Zhao511/WaterQualityMonitoring/web项目说明文档.md

# WaterQualityMonitor 智慧水质监测系统 - Web端说明文档
## 项目概述
本项目是一套基于Web的**智慧水质物联网监测系统**控制面板，搭配以STM32F103C8T6为核心的野外水质监测终端，实现河道、鱼塘、水库等水域水质参数**实时采集、远程监控、设备管理、异常告警**全流程可视化操作，支持点位身份配置、云端对接、阈值预警与设备状态管控，适配野外无人值守式水质常态化监测场景。

---
## 一、标签页结构
系统采用二级导航结构，左侧为一级导航栏，右侧内容区顶部为二级导航栏。
### 1.1 一级导航标签页
| 标签页名称 | 路由标识 | 说明 |
|---|---|---|
| **运营首页** | home | 系统主界面，展示水质传感器数据、设备状态与远程控制功能 |
| **更多信息** | set | 系统参数、平台连接、设备地址配置及版本管理 |

### 1.2 二级导航标签页
#### 运营首页 下包含：
| 标签页名称 | 路由标识 | 说明 |
|---|---|---|
| **主页** | home/main | 核心监控页面，展示全量水质数据、点位信息、设备控制面板与告警设置 |

#### 更多信息 下包含：
| 标签页名称 | 路由标识 | 说明 |
|---|---|---|
| **IDKey** | set/IDKEY | 配置华为云IoT平台连接参数，建立终端与云端数据通道 |
| **MAC设置** | set/MAC | 配置水质监测终端、RFID点位、GPS定位、LoRa通信模块地址 |
| **版本信息** | set/about | 查看系统版本、升级日志、APP下载及本地缓存清理 |

---
## 二、各标签页详细说明
### 2.1 主页（home/main）
**作用**：系统核心监控界面，实时展示水质参数、点位身份、定位信息、设备在线状态，提供阈值设置、模式切换、本地状态查看及告警控制功能。
#### 包含的控件：
| 序号 | 控件名称 | 控件类型 | 说明 |
|-----|---|---|---|
| 1 | **水温面板** | 仪表盘图表 | 显示实时水体温度，范围-20~100℃，附带设备在线/离线状态指示 |
| 2 | **pH值面板** | 仪表盘图表 | 显示水体pH数值，标准监测范围0~14，附带设备在线/离线状态指示 |
| 3 | **电导率(EC/TDS)面板** | 仪表盘图表 | 显示水体电导率/TDS数据，附带设备在线/离线状态指示 |
| 4 | **浊度面板** | 仪表盘图表 | 显示水体浊度数据，附带设备在线/离线状态指示 |
| 5 | **RFID点位标识面板** | 状态显示区 | 展示当前监测点位唯一RFID编号，用于点位溯源与分区管理 |
| 6 | **GPS定位面板** | 状态显示区 | 展示监测点位经纬度信息，支持空间定位与地图关联 |
| 7 | **设备状态指示灯面板** | 状态显示区 | 同步终端RGB三色LED状态，直观展示水质正常/异常/预警状态 |
| 8 | **水质综合告警面板** | 图片+按钮 | 显示告警状态，点击按钮可手动开启/关闭全域水质异常报警 |
| 9 | **水温阈值滑块** | 滑块控件 | 设置水温报警阈值，范围0~100℃ |
| 10 | **pH值阈值滑块** | 滑块控件 | 设置pH值上下限报警阈值，范围0~14 |
| 11 | **电导率阈值滑块** | 滑块控件 | 设置电导率/TDS报警阈值 |
| 12 | **浊度阈值滑块** | 滑块控件 | 设置浊度报警阈值 |
| 13 | **模式切换** | 单选按钮组 | 自动模式/手动模式切换 |

#### 功能说明：
- **自动模式**：当水温、pH、电导率、浊度任一参数超出预设阈值时，系统自动触发告警；参数恢复正常后告警自动关闭。
- **手动模式**：由管理人员手动开启、关闭水质告警提示。
- 所有终端采集数据、RFID编号、GPS定位信息通过数据服务实时推送，页面自动刷新更新。

### 2.2 IDKey（set/IDKEY）
**作用**：配置与**华为云IoT平台**对接的认证参数，建立前端页面、LoRa网关、水质终端与云端平台的数据传输链路。
#### 包含的控件：
| 序号 | 控件名称 | 控件类型 | 说明 |
|-----|---|---|---|
| 1 | **ID输入框** | 文本输入框 | 华为云IoT平台设备/账户ID |
| 2 | **KEY输入框** | 文本输入框 | 华为云IoT平台接入密钥 |
| 3 | **SERVER输入框** | 文本输入框 | 华为云IoT平台服务器地址 |
| 4 | **确认按钮** | 按钮 | 保存参数，连接/断开云端数据服务 |
| 5 | **扫描按钮** | 按钮 | 安卓端可用，扫描二维码自动填充ID/KEY/服务器地址 |
| 6 | **分享按钮** | 按钮 | 生成当前云平台配置二维码，供其他设备快速导入配置 |

### 2.3 MAC设置（set/MAC）
**作用**：配置各硬件模块通信地址，区分不同监测终端、传感器、RFID点位、LoRa网关设备，精准接收多点位水质数据。
#### 包含的控件：
| 序号 | 控件名称 | 控件类型 | 说明 |
|-----|---|---|---|
| 1 | **Sensor_A输入框** | 文本输入框 | 水质综合传感器MAC（水温、pH、电导率、浊度） |
| 2 | **Sensor_B输入框** | 文本输入框 | RFID点位识别模块MAC，用于点位身份校验与溯源 |
| 3 | **Sensor_C输入框** | 文本输入框 | GPS定位+LoRa通信模块MAC，负责定位与无线数据传输 |
| 4 | **确认按钮** | 按钮 | 保存MAC地址并查询各模块在线运行状态 |
| 5 | **扫描按钮** | 按钮 | 安卓端可用，扫描二维码自动批量填充MAC地址 |
| 6 | **分享按钮** | 按钮 | 生成当前MAC配置二维码，便于多设备统一配置 |

#### 传感器/模块分工：
| 设备模块 | 采集/实现功能 |
|---|---|
| Sensor_A | 水温、pH值、电导率(EC/TDS)、浊度四大水质参数采集 |
| Sensor_B | RFID电子标签识别，点位身份编码、巡检溯源、分区管理 |
| Sensor_C | GPS经纬度定位、LoRa低功耗无线数据收发传输 |

### 2.4 版本信息（set/about）
**作用**：查看系统版本、升级日志，提供移动端APP下载入口与浏览器本地缓存清理功能。
#### 包含的控件：
| 序号 | 控件名称 | 控件类型 | 说明 |
|-----|---|---|---|
| 1 | **查看下载二维码** | 链接/按钮 | 弹出模态框显示安卓APP下载二维码，移动端扫码即可安装 |
| 2 | **当前版本显示** | 文本显示 | 展示Web管理端当前软件版本号 |
| 3 | **版本升级按钮** | 按钮 | 在线检查并执行系统版本升级 |
| 4 | **查看升级日志按钮** | 按钮 | 展开/收起系统版本迭代、功能更新历史记录 |
| 5 | **清除localStorage按钮** | 按钮 | 清除浏览器本地缓存的云平台参数、MAC地址、阈值等配置数据 |

---
## 三、公共控件与模态框
### 3.1 二维码分享窗口（qrModal）
- 用于分享华为云IDKey、设备MAC等配置信息
- 生成JSON格式二维码，其他设备扫码可一键导入配置，快速部署

### 3.2 下载二维码窗口（downloadModal）
- 展示移动端管理APP下载二维码
- 手机扫码可直接下载安装安卓客户端，实现移动端远程监控

### 3.3 延时弹出提示框（toast）
- 页面右下角自动弹出操作反馈提示，超时自动消失
- 用于展示云端连接状态、配置保存结果、设备在线状态、告警触发等信息

---
## 四、配置文件说明
### config.js 核心配置项：
| 配置项 | 默认值 | 说明 |
|---|---|---|
| id | 1234567890 | 华为云IoT平台用户/设备ID |
| key | ABCDEFGHIJKLMNOPQRSTUVWXYZ | 华为云IoT平台接入密钥 |
| server | iot-cloud.huawei.com | 华为云IoT平台服务器地址 |
| Sensor_A | 00:00:00:00:00:00:00:00 | 水质综合传感器MAC地址 |
| Sensor_B | 00:00:00:00:00:00:00:00 | RFID点位模块MAC地址 |
| Sensor_C | 00:00:00:00:00:00:00:00 | GPS+LoRa通信模块MAC地址 |
| curMode | manual-mode | 系统默认运行模式：手动模式 |
| Tem_threshold | 50 | 水温默认报警阈值 |
| Ph_min | 6 | pH值下限报警阈值 |
| Ph_max | 9 | pH值上限报警阈值 |
| Ec_threshold | 1000 | 电导率默认报警阈值 |
| Turb_threshold | 500 | 浊度默认报警阈值 |

---
## 五、技术架构
| 技术/库 | 用途 |
|---|---|
| jQuery | 页面DOM操作、事件监听与数据交互 |
| Bootstrap | 搭建响应式前端UI界面，适配电脑、平板、手机 |
| FusionCharts | 水质参数仪表盘、数据图表可视化展示 |
| Director.js | 前端路由管理，实现多标签页切换 |
| nstSlider | 各类水质参数阈值调节滑块控件 |
| labelauty | 单选按钮美化，优化模式切换交互体验 |
| QRCode.js | 动态生成配置分享、APP下载二维码 |
| 云端数据服务 | 对接华为云IoT平台，接收STM32终端上传的水质、定位、RFID数据 |

*文档生成日期：2026-06-05*
