Zhao511/WaterQualityMonitoring/(list of files, drawings)

Other design files:
Untitled Sketch 2.fzz
