Zhao511/WaterQualityMonitoring/WaterQuality_Terminal/Core/Src/main.c

/**
 * ============================================================
 * 智慧水质监测系统 — FreeRTOS + 华为云 IoT 物模型
 * ============================================================
 * 架构: STM32F103 ←LoRa→ ESP32网关 ←MQTT→ 华为云IoT
 * MCU:  STM32F103C8T6  |  RTOS: FreeRTOS
 * SRAM: 20KB           |  Flash: 64KB
 * ============================================================
 * 任务架构 (6 个任务):
 *
 *   vWatchdogTask(Prio 4, Stack 128W) — IWDG 看门狗监控 + 心跳检查
 *   vSensorTask  (Prio 3, Stack 384W) — 传感器 5s 采集 + 告警判定
 *   vGPSTask     (Prio 2, Stack 256W) — GPS 1s 轮询 (按需开启) + NMEA→Decimal
 *   vIOTTask     (Prio 2, Stack 512W) — LoRa 收发 + 4 服务上报 + 命令处理
 *   vRFIDTask    (Prio 1, Stack 128W) — RFID 2s 扫描
 *   vLEDTask     (Prio 1, Stack 128W) — 水质 & 命令 LED 指示
 * ============================================================
 */

#include "stm32f10x.h"

/* FreeRTOS */
#include "FreeRTOS.h"
#include "task.h"
#include "queue.h"
#include "semphr.h"

/* 驱动层 */
#include "led_rgb.h"
#include "sensor_ph.h"
#include "sensor_turbidity.h"
#include "sensor_temp.h"
#include "sensor_tds.h"
#include "adc_common.h"
#include "lora.h"
#include "gps.h"
#include "rc522.h"
#include "usart_debug.h"
#include "watchdog.h"

/* IoT 物模型 */
#include "iot_model.h"
#include "iot_json.h"
#include "iot_service.h"

#include <stdio.h>
#include <string.h>

/* ================================================================
 * 编译期开关: 原始 ADC 诊断输出
 *   0 = 禁用 (生产模式, 节省栈空间)
 *   1 = 启用 (调试模式, 每 60 轮输出一次原始 ADC 值)
 * ================================================================ */
#define RAW_ADC_DEBUG_ENABLED  0

/* ================================================================
 * 全局物模型实例 (iot_service.h 中 extern 声明)
 * ================================================================ */
WaterStatus  g_water_status;
DeviceStatus g_device_status;
GPS          g_gps_data;
uint32_t     g_report_interval_sec = IOT_DEFAULT_REPORT_INTERVAL;
uint8_t      g_terminal_addr = 0;    /* 终端LoRa地址: 0=广播, 读到RFID后自动设为UID最后一字节 */
bool         g_gps_enabled  = false;  /* GPS按需开关: 上报窗口期/命令请求时开启 */
bool         g_pending_device_status_report = false;  /* A0/A1 触发延迟上报 */

/* ================================================================
 * 旧版数据结构 (保留用于队列兼容, 后续逐步迁移)
 * ================================================================ */
typedef struct {
    float ph;
    float turbidity;
    float temperature;
    float tds;
} SensorData;

typedef struct {
    uint8_t tag_id[5];
    uint8_t tag_valid;
} RFIDData;

/* ================================================================
 * FreeRTOS 队列 & 互斥量
 * ================================================================ */
static QueueHandle_t xSensorQueue  = NULL;
static QueueHandle_t xGPSQueue     = NULL;
static QueueHandle_t xRFIDQueue    = NULL;
static QueueHandle_t xLEDQueue     = NULL;
static QueueHandle_t xAlarmQueue   = NULL;   /* 告警事件队列 */
static SemaphoreHandle_t xDebugMutex = NULL;
static SemaphoreHandle_t xWaterMutex = NULL;  /* 保护 g_water_status 并发访问 */
static SemaphoreHandle_t xGPSMutex   = NULL;  /* 保护 g_gps_data 并发访问 */
SemaphoreHandle_t xADCMutex   = NULL;  /* 保护 ADC1 并发访问 (extern 给 adc_common.c) */
static TaskHandle_t xWatchdogTaskHandle = NULL;

/* 任务运行计数器 (周期性日志输出, 避免刷屏) */
static uint32_t g_sensor_cycle = 0;
static uint32_t g_gps_cycle    = 0;
static uint32_t g_iot_cycle    = 0;
static uint32_t g_rfid_cycle   = 0;
static uint32_t g_led_cycle    = 0;

/* 即时上报信号 */
static TaskHandle_t xSensorTaskHandle = NULL;
TaskHandle_t xIOTTaskHandle = NULL;
#define IOT_IMMEDIATE_REPORT_BIT   0x01

/* ================================================================
 * 函数声明
 * ================================================================ */
static uint8_t  ReadRFIDTag(uint8_t *tag_id, uint8_t *out_status);

/* 任务函数 */
static void vSensorTask(void *pvParameters);
static void vGPSTask(void *pvParameters);
static void vRFIDTask(void *pvParameters);
static void vIOTTask(void *pvParameters);
static void vLEDTask(void *pvParameters);
static void vWatchdogTask(void *pvParameters);

/* 传输层外部函数 (iot_transport.c) */
extern void IOT_Report_DeviceStatus(const DeviceStatus *s);
extern void IOT_Report_WaterStatus(const WaterStatus *s);
extern void IOT_Report_Alarm(const Alarm *a);
extern void IOT_Report_GPS(const GPS *g);
extern void IOT_Process_Incoming(void);
extern void IOT_Collect_All_Sensors(WaterStatus *ws);

/* ================================================================
 * RFID 读卡辅助
 * ================================================================ */
static uint8_t ReadRFIDTag(uint8_t *tag_id, uint8_t *out_status)
{
    uint8_t status;
    uint8_t tag_type[2];

    status = RC522_Request(PICC_REQA, tag_type);
    if (out_status) *out_status = status;
    if (status != MI_OK) return 0;

    status = RC522_SelectTag(tag_id);
    return (status == MI_OK) ? 1 : 0;
}

/* ================================================================
 * 任务 1 — 传感器采集 (Prio 3, 5s 周期, 常态 RX 不频繁切换)
 * ================================================================ */
static void vSensorTask(void *pvParameters)
{
    TickType_t xLastWakeTime = xTaskGetTickCount();
    const TickType_t xPeriod = pdMS_TO_TICKS(5000);  /* 5s 采集, 常态 RX */

    SensorData sensor_data;

    for (;;)
    {
        /* 首次启动延时: 确保 ADC、传感器供电和外部电路完全稳定 */
        if (g_sensor_cycle == 0) {
            vTaskDelay(pdMS_TO_TICKS(500));
        }

        /* 读取所有传感器 + 校准 + 物理范围验证 */
        float raw_ph, raw_temp, raw_tds;

        raw_ph = IOT_Apply_Calibration("ph", PH_Sensor_Read());
        IOT_Validate_SensorData("ph", raw_ph, &sensor_data.ph);

#if TURBIDITY_SENSOR_ENABLED
        {
            float raw_turb = IOT_Apply_Calibration("turbidity", Turbidity_Sensor_Read());
            IOT_Validate_SensorData("turbidity", raw_turb, &sensor_data.turbidity);
        }
#else
        sensor_data.turbidity   = 0;  /* 无浊度传感器, 固定为 0 */
#endif

        raw_temp = IOT_Apply_Calibration("temp", Temp_Sensor_Read());
        IOT_Validate_SensorData("temp", raw_temp, &sensor_data.temperature);

        /* 温度合理性检查 → TDS 补偿用 (使用物理范围常量) */
        float temp = sensor_data.temperature;
        if (temp < IOT_TEMP_VALID_MIN || temp > IOT_TEMP_VALID_MAX)
            temp = IOT_TEMP_DEFAULT;

        raw_tds = IOT_Apply_Calibration("tds", TDS_Sensor_Read(temp));
        IOT_Validate_SensorData("tds", raw_tds, &sensor_data.tds);

        /* 更新全局物模型 WaterStatus (加锁保护) */
        if (xSemaphoreTake(xWaterMutex, pdMS_TO_TICKS(50)) == pdPASS)
        {
            g_water_status.ph        = sensor_data.ph;
            g_water_status.tds       = sensor_data.tds;
            g_water_status.temp      = sensor_data.temperature;
            g_water_status.turbidity = sensor_data.turbidity;
            xSemaphoreGive(xWaterMutex);
        }

        /* 写入传感器队列 (供 IOT 任务消费) */
        xQueueOverwrite(xSensorQueue, &sensor_data);

        /* 水质评估 → LED (已移除: LED 由平台 A0/A1 告警命令控制) */

        /* 告警检测已移至 Web/App 端 — 终端不再做阈值判断
         * Alarm alarm;
         * if (IOT_Alarm_Check(&g_water_status, g_water_status.rfid, &alarm) != 0) {
         *     xQueueSend(xAlarmQueue, &alarm, 0);
         * } */

        /* 调试输出 (含阈值, 便于判断 LED 颜色原因) */
        if (xSemaphoreTake(xDebugMutex, pdMS_TO_TICKS(100)) == pdPASS)
        {
            Debug_Printf("PH:%.2f[%.1f-%.1f] TDS:%.1f[<%.0f] Temp:%.1f[%.0f-%.0f] Turb:%.1f\r\n",
                         sensor_data.ph, g_water_status.ph_min, g_water_status.ph_max,
                         sensor_data.tds, g_water_status.tds_max,
                         sensor_data.temperature, g_water_status.temp_min, g_water_status.temp_max,
                         sensor_data.turbidity);
            /* LED 判定细节 */
            uint8_t fc = 0;
            if (sensor_data.ph < g_water_status.ph_min || sensor_data.ph > g_water_status.ph_max) fc++;
            if (sensor_data.tds > g_water_status.tds_max) fc++;
            if (sensor_data.temperature < g_water_status.temp_min || sensor_data.temperature > g_water_status.temp_max) fc++;
            Debug_Printf("[Sensor] fail_count=%u -> LED=%s | cycle=%lu\r\n",
                         fc,
                         fc == 0 ? "GREEN" : (fc == 1 ? "YELLOW" : "RED"),
                         (unsigned long)g_sensor_cycle);
            xSemaphoreGive(xDebugMutex);
        }

        /* 心跳 + 周期日志 (每 10 轮 ≈ 10s 输出摘要) */
        g_sensor_cycle++;
        WDG_Heartbeat(HEARTBEAT_SENSOR);

        if ((g_sensor_cycle % 10) == 0) {
            if (xSemaphoreTake(xDebugMutex, pdMS_TO_TICKS(100)) == pdPASS) {
                Debug_Printf("[Sensor] cycle=%lu | PH=%.2f TDS=%.1f Temp=%.1f Turb=%.1f\r\n",
                             g_sensor_cycle, sensor_data.ph, sensor_data.tds,
                             sensor_data.temperature, sensor_data.turbidity);
                xSemaphoreGive(xDebugMutex);
            }
        }

#if RAW_ADC_DEBUG_ENABLED
        /* 诊断: 每 10 轮 (~10s) 输出原始 ADC 采样值
         *   - 放在 WDG_Heartbeat 之后: 故障前心跳已上报
         *   - 使用 xDebugMutex 保护 Debug_Printf */
        if ((g_sensor_cycle % 10) == 0) {
            uint16_t r_ph, r_tds, r_turb, r_temp;
            uint8_t  ok_ph, ok_tds, ok_turb, ok_temp;
            ok_ph   = ADC_ReadChannel(ADC_CH_PH,        &r_ph);
            ok_tds  = ADC_ReadChannel(ADC_CH_TDS,       &r_tds);
            ok_turb = ADC_ReadChannel(ADC_CH_TURBIDITY, &r_turb);
            ok_temp = ADC_ReadChannel(ADC_CH_TEMP,      &r_temp);
            if (xSemaphoreTake(xDebugMutex, pdMS_TO_TICKS(100)) == pdPASS) {
                Debug_Printf("[RAW ADC] cycle=%lu | pH=%s%u TDS=%s%u Turb=%s%u Temp=%s%u\r\n",
                             g_sensor_cycle,
                             (ok_ph   == ADC_READ_OK) ? "" : "TMO:", r_ph,
                             (ok_tds  == ADC_READ_OK) ? "" : "TMO:", r_tds,
                             (ok_turb == ADC_READ_OK) ? "" : "TMO:", r_turb,
                             (ok_temp == ADC_READ_OK) ? "" : "TMO:", r_temp);
                xSemaphoreGive(xDebugMutex);
            }
        }
#endif

        vTaskDelayUntil(&xLastWakeTime, xPeriod);
    }
}

/* ================================================================
 * 任务 2 — GPS 解析 (Prio 2, 1s 周期)
 * ================================================================ */
static void vGPSTask(void *pvParameters)
{
    GPS_Data raw_gps;

    for (;;)
    {
        if (g_gps_enabled) {
            GPS_ProcessData();
            GPS_GetData(&raw_gps);

            if (raw_gps.fix > 0)
            {
                xQueueOverwrite(xGPSQueue, &raw_gps);

                /* 转换为物模型 GPS (decimal degrees), 加锁保护 */
                if (xSemaphoreTake(xGPSMutex, pdMS_TO_TICKS(50)) == pdPASS)
                {
                    IOT_GPS_GetDecimal(&g_gps_data);
                    xSemaphoreGive(xGPSMutex);
                }

                if (xSemaphoreTake(xDebugMutex, pdMS_TO_TICKS(100)) == pdPASS)
                {
                    Debug_Printf("GPS: %.6f,%.6f Fix=%d Sat=%d\r\n",
                                 g_gps_data.latitude, g_gps_data.longitude,
                                 raw_gps.fix, raw_gps.satellites);
                    xSemaphoreGive(xDebugMutex);
                }

                /* 电子围栏检查已移至 Web/App 端 — 终端不再做告警判定
                 * if ((g_gps_cycle % 10) == 0) {
                 *     if (IOT_GeoFence_Check(...) != 0) { ... }
                 * } */
            }

            g_gps_cycle++;

            if ((g_gps_cycle % 10) == 0) {
                if (xSemaphoreTake(xDebugMutex, pdMS_TO_TICKS(100)) == pdPASS) {
                    Debug_Printf("[GPS] cycle=%lu | Fix=%d Sat=%d\r\n",
                                 g_gps_cycle, raw_gps.fix, raw_gps.satellites);
                    xSemaphoreGive(xDebugMutex);
                }
            }
        }

        WDG_Heartbeat(HEARTBEAT_GPS);
        vTaskDelay(pdMS_TO_TICKS(1000));  /* 1s 周期, GPS使能时读数, 禁用时空转 */
    }
}

/* ================================================================
 * 任务 3 — RFID 扫描 (Prio 1, 2s 周期)
 * ================================================================ */
static void vRFIDTask(void *pvParameters)
{
    TickType_t xLastWakeTime = xTaskGetTickCount();
    const TickType_t xPeriod = pdMS_TO_TICKS(2000);  /* 2s RFID, 降低总线占用 */

    RFIDData rfid = {0};
    uint8_t  last_status = 0xFF;  /* 最近一次 RC522_Request 状态 */

    for (;;)
    {
        rfid.tag_valid = ReadRFIDTag(rfid.tag_id, &last_status);

        if (rfid.tag_valid)
        {
            xQueueOverwrite(xRFIDQueue, &rfid);

            /* 更新物模型 RFID */
            snprintf(g_water_status.rfid, IOT_RFID_LEN,
                     "%02X%02X%02X%02X%02X",
                     rfid.tag_id[0], rfid.tag_id[1],
                     rfid.tag_id[2], rfid.tag_id[3],
                     rfid.tag_id[4]);

            /* 从 RFID UID 最后一字节自动派生终端 LoRa 地址
             * 避开 0x00(广播) 和 0xFF(保留), 确保每个终端有唯一地址 */
            g_terminal_addr = rfid.tag_id[4];
            if (g_terminal_addr == 0 || g_terminal_addr == 0xFF) {
                g_terminal_addr = 1;
            }

            if (xSemaphoreTake(xDebugMutex, pdMS_TO_TICKS(100)) == pdPASS)
            {
                Debug_Printf("RFID: %s\r\n", g_water_status.rfid);
                xSemaphoreGive(xDebugMutex);
            }
        }

        /* 心跳 + 周期日志 (每 10 轮 ≈ 5s 输出摘要) */
        g_rfid_cycle++;
        WDG_Heartbeat(HEARTBEAT_RFID);

        if ((g_rfid_cycle % 10) == 0) {
            if (xSemaphoreTake(xDebugMutex, pdMS_TO_TICKS(100)) == pdPASS) {
                Debug_Printf("[RFID] cycle=%lu | stat=%d (0=OK 1=NOTAG 2=ERR)\r\n",
                             g_rfid_cycle, last_status);
                xSemaphoreGive(xDebugMutex);
            }
        }

        vTaskDelayUntil(&xLastWakeTime, xPeriod);
    }
}

/* ================================================================
 * 任务 4 — IoT 通信 (Prio 2, 可调上报周期)
 *   - 消费 LoRa RX → 命令解析分发
 *   - 定时上报 4 服务属性 (WaterStatus/DeviceStatus/GPS/Alarm)
 * ================================================================ */
static void vIOTTask(void *pvParameters)
{
    TickType_t xLastWakeTime = xTaskGetTickCount();
    uint32_t   tick_count    = 0;
    uint32_t   last_device_status = 0;
    uint32_t   last_gps_report    = 0;

    SensorData sensor_data;
    RFIDData   rfid_data;
    GPS_Data   raw_gps;
    Alarm      alarm;

    /* tick_count 为秒计数器, 直接与秒值比较 */
    tick_count = 1;  /* 从 1 开始, 避免首发空数据 */

    /* 启动延迟: 等 ESP32 完成 WiFi+NTP+MQTT 初始化 (~15s)
     * 分段 delay + 喂狗, 避免触发 WDG 复位 */
    Debug_Printf("[IoT] Waiting 15s for ESP32 gateway init...\r\n");
    for (int i = 0; i < 15; i++) {
        vTaskDelay(pdMS_TO_TICKS(1000));
        WDG_Heartbeat(HEARTBEAT_IOT);
    }
    Debug_Printf("[IoT] Start reporting\r\n");

    for (;;)
    {
        /* 诊断: 每 60 次循环 (~60s) 输出存活日志, 生产环境避免每秒打印
         * 注释: 将 % 60 改为 % 1 可恢复每秒打印 (调试用) */
        if ((tick_count % 60) == 0) {
            static uint32_t last_tick_time = 0;
            uint32_t now_tick = xTaskGetTickCount();
            uint32_t elapsed = (last_tick_time > 0) ? (now_tick - last_tick_time) : 0;
            Debug_Printf("[IoT] alive tick=%lu (elapsed=%lums)\r\n",
                         tick_count, (unsigned long)(elapsed * portTICK_PERIOD_MS));
            last_tick_time = now_tick;
        }

        /* --- LoRa 下行命令处理 (每次循环都检查) --- */
        IOT_Process_Incoming();

        /* --- 检查即时上报信号 --- */
        uint32_t notify;
        if (xTaskNotifyWait(0, 0, &notify, 0) == pdTRUE)
        {
            if (notify & IOT_IMMEDIATE_REPORT_BIT)
            {
                /* request_immediate_report: 全量采集 + 立即上报所有服务
                 * 加锁保护: 防止 vSensorTask(Prio3) 抢占造成数据撕裂 */
                if (xSemaphoreTake(xWaterMutex, pdMS_TO_TICKS(100)) == pdPASS)
                {
                    IOT_Collect_All_Sensors(&g_water_status);
                    IOT_Report_WaterStatus(&g_water_status);
                    IOT_DeviceStatus_Update(&g_device_status);
                    IOT_Report_DeviceStatus(&g_device_status);
                    if (xSemaphoreTake(xGPSMutex, pdMS_TO_TICKS(50)) == pdPASS)
                    {
                        IOT_Report_GPS(&g_gps_data);
                        xSemaphoreGive(xGPSMutex);
                    }
                    xSemaphoreGive(xWaterMutex);
                }
            }
        }

        /* --- 非阻塞消费各数据队列 (更新物模型) --- */
        xQueueReceive(xSensorQueue, &sensor_data, 0);
        xQueueReceive(xGPSQueue,    &raw_gps,     0);
        xQueueReceive(xRFIDQueue,   &rfid_data,   0);

        /* --- 定时: Water_status 上报 (可调间隔, 默认 5s) --- */
        if ((tick_count % g_report_interval_sec) == 0)
        {
            /* 更新 GPS 文本 (点位地理位置), 加锁保护
             * 仅在有 GPS Fix 时更新坐标; 无定位时设为空字符串 */
            if (xSemaphoreTake(xWaterMutex, pdMS_TO_TICKS(50)) == pdPASS)
            {
                if (xSemaphoreTake(xGPSMutex, pdMS_TO_TICKS(50)) == pdPASS)
                {
                    if (g_gps_data.gps_status != GPS_NO_FIX)
                    {
                        snprintf(g_water_status.gps, IOT_GPS_STR_LEN,
                                 "%.6f,%.6f", g_gps_data.longitude, g_gps_data.latitude);
                    }
                    else
                    {
                        g_water_status.gps[0] = '\0';  /* 未定位: 空字符串 */
                    }
                    xSemaphoreGive(xGPSMutex);
                }
                IOT_Report_WaterStatus(&g_water_status);
                xSemaphoreGive(xWaterMutex);
            }
        }

        /* --- 定时: DeviceStatus 上报 (60s) --- */
        if (tick_count - last_device_status >= IOT_DEVICE_STATUS_INTERVAL)
        {
            IOT_DeviceStatus_Update(&g_device_status);
            IOT_Report_DeviceStatus(&g_device_status);
            last_device_status = tick_count;
        }

        /* --- 定时: GPS 上报 (60s, 按需开启) ---
         * 上报前 15s 开启 GPS 预热, 上报后关闭以省电 */
        #define GPS_WARMUP_SEC  15
        if (tick_count - last_gps_report >= (IOT_GPS_REPORT_INTERVAL - GPS_WARMUP_SEC))
        {
            g_gps_enabled = true;  /* 提前开启预热 */
        }
        if (tick_count - last_gps_report >= IOT_GPS_REPORT_INTERVAL)
        {
            if (xSemaphoreTake(xGPSMutex, pdMS_TO_TICKS(50)) == pdPASS)
            {
                IOT_Report_GPS(&g_gps_data);
                xSemaphoreGive(xGPSMutex);
            }
            last_gps_report = tick_count;
            g_gps_enabled = false;  /* 上报完成, 关闭 GPS */
        }

        /* --- Alarm 上报 (限流: 最短间隔内同类型+相近值只发一次) --- */
        {
            static Alarm     last_sent;
            static uint32_t  last_sent_tick = 0;
            static bool      has_last = false;
            #define ALARM_MIN_INTERVAL_SEC  10    /* 同类告警最小间隔 */

            /* 只取队列最新一条, 中间积压的丢弃 */
            Alarm latest;
            bool  has_alarm = false;
            while (xQueueReceive(xAlarmQueue, &alarm, 0) == pdPASS)
            {
                latest = alarm;
                has_alarm = true;
            }

            if (has_alarm)
            {
                /* 去重: 同类型 + 值变化<0.5 且间隔<10s → 跳过 */
                bool same_type = has_last &&
                    (latest.alarm_type == last_sent.alarm_type);
                float val_diff = (latest.current_value > last_sent.current_value)
                    ? (latest.current_value - last_sent.current_value)
                    : (last_sent.current_value - latest.current_value);
                uint32_t elapsed = tick_count - last_sent_tick;

                if (!has_last ||
                    !same_type ||
                    val_diff >= 0.5f ||
                    elapsed >= ALARM_MIN_INTERVAL_SEC)
                {
                    IOT_Report_Alarm(&latest);
                    last_sent      = latest;
                    last_sent_tick = tick_count;
                    has_last       = true;
                }
                /* 调试: 去重跳过时打印原因 */
                else if (xSemaphoreTake(xDebugMutex, pdMS_TO_TICKS(50)) == pdPASS)
                {
                    Debug_Printf("[IoT] Alarm %s suppressed (same type, diff=%.2f, %lus ago)\r\n",
                                 latest.alarm_id, val_diff, elapsed);
                    xSemaphoreGive(xDebugMutex);
                }
            }
        }

        /* ---- 上报后立即检查 RX (防止 TX 期间到达的数据积压) ---- */
        IOT_Process_Incoming();

        /* A0/A1 触发的延迟 DeviceStatus 上报 (避免在 IOT_Process_Incoming 内同步阻塞) */
        if (g_pending_device_status_report) {
            g_pending_device_status_report = false;
            IOT_DeviceStatus_Update(&g_device_status);
            IOT_Report_DeviceStatus(&g_device_status);
        }

        /* 心跳 + 周期日志 (每 5 轮 ≈ 5s 输出摘要) */
        g_iot_cycle++;
        WDG_Heartbeat(HEARTBEAT_IOT);

        if ((g_iot_cycle % 30) == 0) {
            if (xSemaphoreTake(xDebugMutex, pdMS_TO_TICKS(100)) == pdPASS) {
                Debug_Printf("[IoT] cycle=%lu | interval=%lus\r\n",
                             g_iot_cycle, g_report_interval_sec);
                xSemaphoreGive(xDebugMutex);
            }
        }

        tick_count++;
        vTaskDelay(pdMS_TO_TICKS(1000));  /* 1s 主循环 */
    }
}

/* ================================================================
 * 任务 5 — LED 状态指示 (Prio 1, 阻塞等待)
 * ================================================================ */
static void vLEDTask(void *pvParameters)
{
    LED_Color last_color = LED_COLOR_GREEN;  /* 初始为绿灯 */

    /* 确保初始 LED 状态正确 */
    LED_RGB_SetColor(LED_COLOR_GREEN);

    for (;;)
    {
        /* LED 由平台告警命令 (A0/A1) 控制, 此处周期同步确保一致性 */
        LED_Color color = g_device_status.alarm_active ? LED_COLOR_RED : LED_COLOR_GREEN;

        if (color != last_color) {
            LED_RGB_SetColor(color);
            if (xSemaphoreTake(xDebugMutex, pdMS_TO_TICKS(100)) == pdPASS) {
                Debug_Printf("[LED] -> %s (alarm_active=%s)\r\n",
                             g_device_status.alarm_active ? "RED" : "GREEN",
                             g_device_status.alarm_active ? "true" : "false");
                xSemaphoreGive(xDebugMutex);
            }
            last_color = color;
        }

        g_led_cycle++;
        WDG_Heartbeat(HEARTBEAT_LED);

        vTaskDelay(pdMS_TO_TICKS(2000));  /* 2s 周期同步 */
    }
}

/* ================================================================
 * 任务 6 — 看门狗监控 (Prio 4, 1s 周期)
 *   - 检查全部应用任务心跳 → 正常则喂狗, 异常则停止喂狗
 *   - 每 10s 输出心跳状态摘要
 * ================================================================ */
static void vWatchdogTask(void *pvParameters)
{
    TickType_t xLastWakeTime = xTaskGetTickCount();
    const TickType_t xPeriod = pdMS_TO_TICKS(1000);
    uint32_t cycle = 0;

    for (;;)
    {
        WDG_CheckAll();   /* 检查心跳 → 正常则喂狗, 异常则等待 IWDG 复位 */
        cycle++;

        /* 每 10 轮 (~10s) 输出看门狗状态摘要 */
        if ((cycle % 10) == 0) {
            if (xSemaphoreTake(xDebugMutex, pdMS_TO_TICKS(100)) == pdPASS) {
                WDG_PrintStatus();
                xSemaphoreGive(xDebugMutex);
            }
        }

        vTaskDelayUntil(&xLastWakeTime, xPeriod);
    }
}

/* ================================================================
 * main() — 系统初始化 & 调度器启动
 * ================================================================ */

/* FreeRTOS 栈溢出钩子 (configCHECK_FOR_STACK_OVERFLOW=1 时必须实现) */
void vApplicationStackOverflowHook(TaskHandle_t xTask, char *pcTaskName)
{
    (void)xTask;
    Debug_Printf("\r\n[FATAL] Stack overflow in task: %s\r\n", pcTaskName);
    /* 死循环 — 看门狗将在 ~4s 后复位系统 */
    taskDISABLE_INTERRUPTS();
    for (;;) { __NOP(); }
}

int main(void)
{
    /* ==============================================================
     * 最简 LED 闪烁 — 不依赖任何外设，仅验证程序到达 main()
     * 红灯 PB6 (共阳极: 低电平亮)
     * 闪烁 3 次 = main() 被成功调用
     * ============================================================== */
    {
        volatile uint32_t delay;
        RCC->APB2ENR |= RCC_APB2Periph_GPIOB;
        GPIOB->CRL &= ~((uint32_t)0x0F << 24);
        GPIOB->CRL |=  (uint32_t)0x03 << 24;
        GPIOB->BSRR = 0x0040;

        for (int n = 0; n < 3; n++)
        {
            GPIOB->BRR  = 0x0040;
            for (delay = 0; delay < 2400000; delay++) { __NOP(); }
            GPIOB->BSRR = 0x0040;
            for (delay = 0; delay < 2400000; delay++) { __NOP(); }
        }
    }

    /* ---- 硬件初始化 ---- */
    /* 调试串口必须最先初始化, 否则 LoRa/GPS 阻塞时无任何输出 */
    Debug_USART_Init();

    /* LED 闪 1 次: Debug_USART_Init 完成 */
    {
        volatile uint32_t d;
        GPIOB->BRR = 0x0040; for (d=0; d<800000; d++) __NOP();
        GPIOB->BSRR = 0x0040; for (d=0; d<800000; d++) __NOP();
    }

    SCB->SHCSR |= (1UL << 16)   /* MEMFAULTENA */
               | (1UL << 17)   /* BUSFAULTENA  */
               | (1UL << 18);  /* USGFAULTENA  */

    /* LED 闪 2 次: SHCSR 配置完成 */
    {
        volatile uint32_t d;
        for (int i=0; i<2; i++) {
            GPIOB->BRR = 0x0040; for (d=0; d<800000; d++) __NOP();
            GPIOB->BSRR = 0x0040; for (d=0; d<800000; d++) __NOP();
        }
    }

    Debug_Printf("\r\n");
    Debug_Printf("========================================\r\n");
    Debug_Printf("[BOOT] System starting... SYSCLK=%lu Hz\r\n", SystemCoreClock);
    {
        /* 复位检测: 打印 RCC 复位标志, 定位是上电复位还是看门狗复位 */
        uint32_t csr = RCC->CSR;
        Debug_Printf("[BOOT] RCC_CSR=0x%08lX", (unsigned long)csr);
        if (csr & 0x01000000) Debug_Printf(" LPWR");    /* 低功耗复位 */
        if (csr & 0x04000000) Debug_Printf(" WDG");      /* 窗口/独立看门狗复位 */
        if (csr & 0x08000000) Debug_Printf(" SW");       /* 软件复位 */
        if (csr & 0x10000000) Debug_Printf(" POR");      /* 上电复位 */
        if (csr & 0x20000000) Debug_Printf(" PIN");      /* 引脚复位 */
        Debug_Printf("\r\n");
        RCC->CSR |= 0x01000000;  /* 清除所有复位标志 */
    }
    Debug_Printf("========================================\r\n\r\n");

    /* LED 闪 3 次: 第一条 Debug_Printf 完成 */
    {
        volatile uint32_t d;
        for (int i=0; i<3; i++) {
            GPIOB->BRR = 0x0040; for (d=0; d<800000; d++) __NOP();
            GPIOB->BSRR = 0x0040; for (d=0; d<800000; d++) __NOP();
        }
    }

    /* ---- 逐项硬件初始化 (带进度日志, 便于定位崩溃点) ---- */
    Debug_Printf("[INIT] LED_RGB...\r\n");
    LED_RGB_Init();
    Debug_Printf("[INIT] LED_RGB OK\r\n");

    Debug_Printf("[INIT] ADC_Common...\r\n");
    ADC_Common_Init();
    Debug_Printf("[INIT] ADC_Common OK\r\n");

    Debug_Printf("[INIT] PH_Sensor...\r\n");
    PH_Sensor_Init();
    Debug_Printf("[INIT] PH_Sensor OK\r\n");

    Debug_Printf("[INIT] Turbidity_Sensor...\r\n");
    Turbidity_Sensor_Init();
    Debug_Printf("[INIT] Turbidity_Sensor OK\r\n");

    Debug_Printf("[INIT] Temp_Sensor...\r\n");
    Temp_Sensor_Init();
    Debug_Printf("[INIT] Temp_Sensor OK\r\n");

    Debug_Printf("[INIT] TDS_Sensor...\r\n");
    TDS_Sensor_Init();
    Debug_Printf("[INIT] TDS_Sensor OK\r\n");

    Debug_Printf("[INIT] GPS...\r\n");
    GPS_Init();
    Debug_Printf("[INIT] GPS OK\r\n");

    Debug_Printf("[INIT] LoRa... (AT scan, may take seconds)\r\n");
    LoRa_Init();
    Debug_Printf("[INIT] LoRa OK | AUX=%s (LOW=ready, HIGH=busy)\r\n", 
                LoRa_AuxReady() ? "LOW(ready)" : "HIGH(busy)");

    Debug_Printf("[INIT] RC522...\r\n");
    RC522_Init();
    Debug_Printf("[INIT] RC522 OK\r\n");

    /* 启动指示：绿灯 (alarm_active=false) — LED 由平台告警命令控制 */
    LED_RGB_SetColor(LED_COLOR_GREEN);
    Debug_Printf("\r\n========================================\r\n");
    Debug_Printf(" Water Quality Monitor - FreeRTOS v2.0\r\n");
    Debug_Printf(" STM32F103C8T6 | 72MHz | IoT 4-Service\r\n");
    Debug_Printf("========================================\r\n");

    for (volatile uint32_t i = 0; i < 2000000; i++) { __NOP(); }

    /* ---- IoT 物模型初始化 ---- */
    IOT_DeviceStatus_Init(&g_device_status);
    IOT_Threshold_Init(&g_water_status);
    IOT_Alarm_Init();
    IOT_Calibration_Init();
    memset(&g_gps_data, 0, sizeof(g_gps_data));

    Debug_Printf("IoT Model: 4 services initialized\r\n");

    /* ---- 打印任务配置表 ---- */
    WDG_PrintTaskTable();

    /* ---- 创建 FreeRTOS 队列 ---- */
    xSensorQueue = xQueueCreate(1, sizeof(SensorData));
    xGPSQueue    = xQueueCreate(1, sizeof(GPS_Data));
    xRFIDQueue   = xQueueCreate(1, sizeof(RFIDData));
    xLEDQueue    = xQueueCreate(1, sizeof(LED_Color));
    xAlarmQueue  = xQueueCreate(4, sizeof(Alarm));     /* 告警缓冲 */
    xDebugMutex  = xSemaphoreCreateMutex();
    xWaterMutex  = xSemaphoreCreateMutex();            /* 保护 g_water_status */
    xGPSMutex    = xSemaphoreCreateMutex();            /* 保护 g_gps_data      */
    xADCMutex    = xSemaphoreCreateMutex();            /* 保护 ADC1 并发访问   */

    /* 验证内核对象 */
    if (xSensorQueue == NULL || xGPSQueue    == NULL ||
        xRFIDQueue   == NULL || xLEDQueue    == NULL ||
        xAlarmQueue  == NULL || xDebugMutex  == NULL || xWaterMutex == NULL ||
        xGPSMutex    == NULL || xADCMutex    == NULL)
    {
        LED_RGB_SetColor(LED_COLOR_RED);
        Debug_Printf("FATAL: Failed to create RTOS objects!\r\n");
        for (;;) { __NOP(); }
    }

    Debug_Printf("RTOS heap free: %lu bytes\r\n",
                 (unsigned long)xPortGetFreeHeapSize());

    /* ---- 初始化 IWDG 看门狗 ---- */
    WDG_Init();
    WDG_DebugFreeze();      /* 调试断点时冻结 IWDG, 避免误复位 */
    Debug_Printf("[WDG] IWDG started, timeout ~4s (LSI ~40kHz)\r\n\r\n");

    /* ---- 创建任务 (Prio: Watchdog > Sensor > IOT/GPS > RFID/LED) ---- */
    BaseType_t ret;

    ret = xTaskCreate(vWatchdogTask, "Watchdog", 128, NULL, 4, &xWatchdogTaskHandle);
    if (ret != pdPASS) { LED_RGB_SetColor(LED_COLOR_RED); for (;;); }

    ret = xTaskCreate(vSensorTask, "Sensor", 384, NULL, 3, &xSensorTaskHandle);
    if (ret != pdPASS) { LED_RGB_SetColor(LED_COLOR_RED); for (;;); }

    ret = xTaskCreate(vGPSTask,   "GPS",    256, NULL, 2, NULL);
    if (ret != pdPASS) { LED_RGB_SetColor(LED_COLOR_RED); for (;;); }

    ret = xTaskCreate(vIOTTask,   "IoT",    512, NULL, 2, &xIOTTaskHandle);
    if (ret != pdPASS) { LED_RGB_SetColor(LED_COLOR_RED); for (;;); }

    ret = xTaskCreate(vRFIDTask,  "RFID",   128, NULL, 1, NULL);
    if (ret != pdPASS) { LED_RGB_SetColor(LED_COLOR_RED); for (;;); }

    ret = xTaskCreate(vLEDTask,   "LED",    128, NULL, 1, NULL);
    if (ret != pdPASS) { LED_RGB_SetColor(LED_COLOR_RED); for (;;); }

    Debug_Printf("All tasks created. Starting scheduler...\r\n\r\n");

    /* ---- 启动调度器 ---- */
    vTaskStartScheduler();

    LED_RGB_SetColor(LED_COLOR_RED);
    Debug_Printf("FATAL: Scheduler failed to start!\r\n");
    for (;;) { __NOP(); }
}
