Zhao511/WaterQualityMonitoring/WaterQuality_Terminal/Drivers/Inc/gps.h

#ifndef __GPS_H
#define __GPS_H

#ifdef __cplusplus
 extern "C" {
#endif

#include "stm32f10x.h"

/* ========== GPS 模块: USART2 默认引脚 (PA2=TX, PA3=RX) ==========
 * 说明: GPS 使用 USART2 默认引脚 PA2/PA3。
 *       GPS 模块接线: TX→PA3(RX), RX→PA2(TX)
 */
#define GPS_USART           USART2
#define GPS_USART_RCC       RCC_APB1Periph_USART2
#define GPS_TX_PIN          GPIO_Pin_2
#define GPS_RX_PIN          GPIO_Pin_3
#define GPS_TX_PORT         GPIOA
#define GPS_RX_PORT         GPIOA
#define GPS_USART_IRQn      USART2_IRQn

#define GPS_BUFFER_SIZE     512

typedef struct {
    char    lat[12];
    char    lon[12];
    char    time[10];
    char    lat_hem;      /* 'N' or 'S' */
    char    lon_hem;      /* 'E' or 'W' */
    uint8_t fix;
    uint8_t satellites;
    float   hdop;
    float   altitude;
} GPS_Data;

extern uint8_t  gps_rx_buffer[GPS_BUFFER_SIZE];
extern uint16_t gps_rx_index;

void     GPS_Init(void);
void     GPS_ProcessData(void);
void     GPS_GetData(GPS_Data *data);
uint8_t  GPS_ParseNMEA(const char *nmea, GPS_Data *data);
uint8_t  GPS_ValidateChecksum(const char *nmea);

#ifdef __cplusplus
}
#endif

#endif
