Zhao511/WaterQualityMonitoring/(commit log)

2026-06-14 feat: 智慧水质监测系统全栈项目
    终端: STM32F103C8T6 + FreeRTOS + IWDG看门狗 + 6任务调度
    网关: ESP32 + LoRa透传 + MQTT/TLS + 华为云IoTDA
    Web: Node.js Express + Bootstrap + FusionCharts + IoTDA SDK
    Android: Kotlin + IoTDA SDK + GaugeView仪表盘
    - 4服务物模型: DeviceStatus/Water_status/Alarm/gps
    - 15条云端命令全实现
    - LoRa 9600-8N1透传 + JSON帧分隔
    - 敏感信息已脱敏, secrets/排除上传
    [Untitled Sketch 2.fzz]
2026-06-14 docs: 添加项目 README
2026-06-14 fix: 物模型对齐 & 通信逻辑修复
    P1 (云平台管理):
    - 过滤 LoRa ping 响应不上报云平台 (ESP32 main.cpp)
    - 补全 Alarm 告警中的 device_id/rfid 字段
    - 实现 Alarm stub 命令: set_alarm_mode/clear_alarm/mute_alarm
    P2 (功能完善):
    - 清理 ESP32 thing_model.h WaterStatus 多余 turbidity 字段
    - 实现 sync_time 时间同步 (支持 HH:MM:SS 和 Unix 时间戳)
    - 实现 set_lora_param (通过 AT 指令修改 LoRa 参数)
    - 实现电子围栏检查 (Haversine 公式 + GPS 越界告警)
    P3 (健壮性):
    - ESP32 启用 TLS 证书验证 (setCACert 替代 setInsecure)
    - STM32 支持真实 RSSI 读取 (AT+RSSI?)
    - 新增 LoRa_SendATCmd 通用 AT 指令接口
    Co-Auth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
    [config.h, iot_service.c, iot_service.h, iot_transport.c, lora.c, lora.h, lora_uart.cpp, lora_uart.h]
2026-06-14 fix: LoRa 模块通信兼容性修复
    - ESP32 出厂复位改为条件触发 (地址/信道配置全部失败时才复位)
    - 两端显式配置空中速率为 2.4kbps (AT+RATE=2), 确保不同固件版本一致
    - ESP32 波特率扫描列表去重 (115200重复 → 14400)
    [lora.c, lora_uart.cpp]
2026-06-14 chore: 同步工作区所有修改
    - STM32 项目配置和驱动文件更新
    - ESP32 网关配置更新
    - 新增 LED 测试文件和调试配置
2026-06-14 fix: 修复 ping 无响应 & 云平台不更新设备数据
    问题1 — STM32 ping 无响应:
    - IOT_Get_LoRa_RSSI() 改为启动时查询一次+静态缓存, 不再每5秒切配置模式吞数据
    - 移除 vIOTTask 每5秒调用 RSSI 的 debug 打印
    - ISR 缓冲区溢出改为丢弃新字节而非清空全部 (防止 ping 报文碎片化)
    问题2 — 华为云不更新设备数据:
    - mqtt_report_property() 添加 {"services":[...]} 外层包装
    - 修复前: {"service_id":"X","properties":{...}}
    - 修复后: {"services":[{"service_id":"X","properties":{...}}]}
    - 符合华为云 IoTDA 标准属性上报格式
    [iot_service.c, main.c, mqtt_huawei.cpp]
2026-06-14 docs: 问题汇总文档移至项目根目录
2026-06-15 fix: vIOTTask 栈溢出诊断修复
    - vIOTTask 循环首行添加无条件心跳日志 [IoT] alive tick=N
    (确认任务是否进入循环体)
    - IOT_Process_Incoming 入口添加 RX check 日志
    (确认是否卡在 RX 处理环节)
    - vIOTTask 栈增大: 512→768 words
    (IOT_Cmd_Dispatch 调用链深+大局部变量, 512可能不足)
    - LoRa_SendData TXE/TC 轮询加超时保护
    (防止 USART 硬件异常时 while(FLAG==RESET) 死循环)
    [iot_transport.c, lora.c, main.c]
2026-06-16 fix: STM32 FreeRTOS 堆不足 & LoRa 波特率同步
    - FreeRTOS configTOTAL_HEAP_SIZE: 8KB → 12KB
    (6任务+5队列+3互斥量需 ~8408B, 8KB不足导致调度器无法启动)
    - vIOTTask 栈: 768W → 512W, vGPSTask 栈: 384W → 256W
    (释放堆空间, 512W=2048B 对 IOT_Process_Incoming ~936B 峰值足够)
    - STM32 LORA_BAUD_RATE: 115200 → 9600
    (与 ESP32 透传模式波特率一致, 修复 LoRa 模块无法通信)
    [config.h, lora.h, lora_uart.cpp, main.c, mqtt_huawei.cpp]
2026-06-16 fix: ESP32 lora_init 补全 AT 配置命令, 修复 LoRa 波特率不匹配
    - 添加 AT+BAUD=9600 (透传波特率, 与 STM32 一致)
    - 添加 AT+ADDR=0 (地址)
    - 添加 AT+CH=0 (信道 433MHz)
    - 添加 AT+RATE=2 (空中速率 2.4kbps)
    根因: 简化后的 lora_init 只发 AT+ADDR? 查询, 不发送配置命令,
    模块保留旧固件的透传波特率 115200, 而 ESP32 UART 已切到 9600 → 通信失败
    [lora_uart.cpp]
2026-06-16 fix: ESP32 LORA_BAUD_RATE 改回 115200 匹配模块固定波特率
    - LORA_BAUD_RATE: 9600 → 115200 (模块不支持 AT+BAUD 写命令)
    - 移除无效的 AT+BAUD/AT+ADDR=/AT+CH=/AT+RATE= 配置命令
    - STM32 保持 9600 不变 (两端 UART 波特率独立, RF 通信只看空中参数)
    [config.h, lora_uart.cpp]
2026-06-16 fix: ESP32 AT+BAUD 先切波特率再等响应, 两端统一 9600
    - 发送 AT+BAUD=9600 后立即切 ESP32 UART 到 9600
    (模块收到 AT+BAUD 后立即切波特率再回复, 旧波特率等待会超时)
    - AT+ADDR=0 / AT+CH=0 / AT+RATE=2 在新波特率 9600 下发送
    - ESP32 和 STM32 两端 LoRa 透传波特率统一为 9600
    [config.h, lora_uart.cpp]
2026-06-16 refactor: ESP32 LoRa 统一 9600 波特率, 移除所有切换
    - 删除 LORA_AT_BAUD_RATE (不再区分AT/透传波特率)
    - lora_init 全程 9600: AT配置 + 透传 统一
    - 移除 lora_set_baud 切换调用
    - 与 STM32 侧 LORA_BAUD_RATE=9600 一致
2026-06-16 fix: 恢复 ESP32 LoRa 双波特率 (AT 115200 + 透传 9600)
    - AT 配置模式: 115200 (模块硬件固定, 9600 下无响应)
    - 透传模式: 9600 (AT+BAUD=9600 设置)
    - AT+BAUD 发送后不等旧波特率响应, 直接切 ESP32 UART
    [config.h, lora_uart.cpp]
2026-06-16 fix: ESP32 LoRa 固定 115200, 不再尝试切换波特率
    - 模块 AT+BAUD 无效 (115200切9600后无响应)
    - 全程 115200, 无任何波特率切换
    - 与 STM32 侧 9600 不同, 但不影响 RF 通信
    [config.h, lora_uart.cpp]
2026-06-16 fix: STM32 LORA_BAUD_RATE 改回 115200, 两端统一
    - 两个模块同型号, 均固定 115200 (AT+BAUD 无效)
    - ESP32 和 STM32 统一 115200
    [lora.h]
2026-06-16 docs: 更新问题汇总 — 新增 5 个问题 (FreeRTOS堆/LoRa波特率/AT兼容性)
    - #17 FreeRTOS 堆 8KB 不足 → 12KB
    - #18 vIOTTask 栈溢出诊断 + LoRa TXE/TC 超时保护
    - #19 ESP32 LoRa 透传波特率不匹配 (4轮迭代最终统一115200)
    - #20 ESP32 模块仅支持 AT+AT+ADDR? (AT写命令全部不支持)
    - #21 两端波特率统一 115200
    - 新增经验教训 #7-9
2026-06-16 fix: AT 指令 V1.x→V3.0 迁移 + AUX 时序修复 + LoRa 通信调通
    - lora.c: LoRa_SendAT/LoRa_SendATCmd/LoRa_SetAddress/LoRa_SetChannel 修复 AUX 时序 (先等 HIGH 再等 LOW)
    - lora.c: 所有 AT 指令迁移到 V3.0 格式 (WLRATE/TPOWER/UART/FLASH)
    - iot_service.c: set_lora_param 改为 V3.0 指令
    - ESP32 lora_uart.cpp: 补充 RF 参数配置 (WLRATE/TPOWER/UART/FLASH)
    - 删除所有 E220 兼容代码, 仅保留 ATK-LORA-01 V3.0
    - 更新问题汇总与解决方案 (新增问题 22-26)
    - STM32↔ESP32 LoRa 通信首次调通
    [config.h, iot_service.c, lora.c, lora.h, lora_uart.cpp, main.c]
2026-06-16 fix: 传感器采集模块全面加固 — 数据验证 + 异常保护 + 线程安全
    P0: 新增 IOT_Validate_SensorData() — 4传感器物理范围检查，异常时回退安全值+日志告警
    P1: GPS 未定位时 gps 字段设为空字符串，避免上报假坐标 0.000000,0.000000
    P2: 统一温度有效性阈值 — 两处均使用 iot_model.h 物理范围常量，不受 set_threshold 影响
    P3: 温度传感器完善开路/短路检测 + 末级钳位[-40,125]°C，返回 sentinel 值供验证层捕获
    P4: 即时上报(request_immediate_report)添加 xWaterMutex 保护，防止数据撕裂
    P5: ADC 校准带超时保护 — 替代 #if 0 死循环，超时优雅降级到出厂值
    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
    [adc_common.c, iot_model.h, iot_service.c, iot_service.h, iot_transport.c, main.c, sensor_temp.c]
2026-06-16 chore: 去除硬编码隐私信息，替换为占位符
    - server.js: AK/SK/项目ID/产品ID/接入点 → YOUR_xxx
    - esp32_gateway/config.h: WiFi密码/设备密钥/设备ID/MQTT地址 → YOUR_xxx
    - Android/IoTDAApi.kt: 实例ID/产品ID → YOUR_xxx
2026-06-17 fix: ADC 传感器采集修复 + 任务饿死修复 + SPL V3.5.0 迁移
    **问题修复 (6项):**
    - ADC 全通道 TMO:0 → 替换精简版 SPL 为 ST 官方 V3.5.0 (修复 RSTCAL/CONT/EXTSEL BUG)
    - vSensorTask 栈溢出 → 256W→384W, RAW ADC 调试块移到心跳后
    - IoT/RFID 任务饿死 → Lora_DelayMs 改用 vTaskDelay 让出 CPU
    - Debug_Printf 临界区过长 → 只保护 vsnprintf, UART 发送在临界区外
    - RFID 心跳超时 → 1500ms→3000ms
    - 温度因 ADC 故障返回 25.0°C 默认值
    **库迁移:**
    - 精简版 SPL → STM32F10x_StdPeriph_Lib_V3.5.0
    - 新增 CMSIS/CoreSupport + CMSIS/DeviceSupport
    - 删除旧 stm32f10x.h (避免与 CMSIS 版本冲突)
    - watchdog.h 移除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
    [adc_common.c, adc_common.h]
2026-06-17 docs: 更新 README — 反映 SPL V3.5.0、任务栈、心跳超时、设计决策
    更新内容:
    - 库: 精简版 SPL → ST 官方 V3.5.0
    - 传感器: 新增 Turbidity(PA2)
    - 任务: vSensorTask 栈 256W→384W, 心跳超时表
    - 通信: LoRa FreeRTOS 延迟替代忙等
    - ADC: 单次转换 + SWSTART + 互斥锁
    - 时钟: HSI 回退方案
    - 新增关键设计决策章节
2026-06-17 refactor: 全栈删除 turbidity (浊度) — 物模型无此属性，硬件无此传感器
    删除:
    - Drivers/Src/sensor_turbidity.c (整个文件)
    - Drivers/Inc/sensor_turbidity.h (整个文件)
    STM32 清理:
    - adc_common.h: 删除 ADC_CH_TURBIDITY + TURBIDITY_SENSOR_ENABLED
    - adc_common.c: 删除 PA2 通道配置, NbrOfChannel 4→3
    - iot_model.h: 删除 turbidity/turbidity_max/turbidity_offset 字段 + 默认值宏
    - iot_service.h: 删除注释中的 turbidity 引用
    - iot_service.c: 删除 turbidity 校准/验证/阈值分支
    - iot_transport.c: 删除 IOT_Collect_All_Sensors 中 turbidity 块
    - main.c: 删除 include + SensorData.turbidity + #if 块 + 调试输出 + init
    Web 清理:
    -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
2026-06-17 fix: LoRa RSSI 真实查询 + 硬编码清理
    RSSI 修复:
    - IOT_Get_LoRa_RSSI(): 启动时一次性缓存 → 每30s实时查询 AT+RSSI?
    - 查询失败返回 IOT_RSSI_QUERY_FAILED(-120) 替代硬编码 -55
    - V3.0 固件响应格式 "RSSI:-85" 已兼容
    硬编码清理:
    - iot_model.h: 删除残留 IOT_TURB_VALID_MIN/MAX
    - iot_model.h: 新增 IOT_RSSI_QUERY_FAILED(-120)
    - sensor_temp.c: 25.0f → IOT_TEMP_DEFAULT
    - sensor_ph.c: 7.0f → IOT_PH_DEFAULT
    [iot_model.h, iot_service.c, sensor_ph.c, sensor_temp.c]
2026-06-17 refactor: 优化 ADC 初始化 — 对齐参考项目代码风格
    adc_common.c:
    - 手动寄存器清零 → ADC_DeInit(ADC1) (V3.5.0 标准函数)
    - 删除冗余的 CONT/EXTSEL 手动修正 + 步7关开ADC (V3.5.0已正确处理)
    - GPIO 引脚对齐参考: Temp PA3→PA4 (ADC_Channel_4)
    adc_common.h:
    - ADC_CH_TEMP = ADC_Channel_4 (原 ADC_Channel_3)
    README.md:
    - 传感器 GPIO 更新: PA3→PA4
    [adc_common.c, adc_common.h]
2026-06-21 feat: Android端补齐Web端功能 + Web端多项优化
    Android端:
    - 新增 WebApiService (OkHttp封装) 对接Web后端REST API
    - 新增 AlarmFragment (告警记录页面)
    - 新增 LogFragment + LogManager (日志系统)
    - 新增 ApiResponse 等数据模型
    - 导航扩展为4Tab: 实时监测/告警记录/设备管理/系统设置
    - DeviceListFragment 重写为RecyclerView表格，支持编辑/删除
    - HomeFragment 增强: 状态LED/gpsStatus/lastReport/UNKNOWN状态
    - SettingsFragment 增加版本信息和连接指南
    - 告警/编辑/删除优先使用RFID匹配服务器存储key
    Web端:
    - 修复 DELETE/PUT 路由中 devices 变量未定义Bug
    - 修复 RFID 迁移时旧条目不清理导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
2026-06-22 feat: 帧协议重构 + A0/A1告警 + 隐私清理
    帧协议 (ESP32→STM32):
    - 帧格式: [0xAA][LEN][载荷][XOR校验], 收满整帧才解析
    - 停等ACK: STM32收到完整帧→ACK, ESP32等ACK再发下一包
    - 帧间隔≥200ms, 超时重发最多2次, NAK立即重试
    - STM32状态机: IDLE→GOT_HEADER→READING→GOT_CHECKSUM
    A0/A1极简告警:
    - A0=开启告警(alarm_active=true, LED红)
    - A1=关闭告警(alarm_active=false, LED绿)
    - LED由alarm_active驱动, 移除传感器阈值LED判定
    修复:
    - DeviceStatus补全alarm_active字段
    - USART3 ISR ORE不再丢弃有效字节
    - LoRa_ReceiveData原子交换, 禁ISR仅2指令
    - 看门狗超时适配5s传感器周期
    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
    [adc_common.c, adc_common.h, config.h, gps.c]
2026-06-22 feat: 一网关多终端 + 告警优化 + 碰撞避免 + GPS按需 + 自动模式重构
    - 帧协议扩展: 增加 DST_ADDR 字节, 支持软件终端寻址
    - 终端地址: RFID UID 自动派生, 零配置部署
    - 告警状态上报: A0/A1 异步延迟上报, 避免阻塞导致看门狗超时
    - 自动模式: Web/App 自维护告警状态, 不依赖终端回执
    - 自动关闭: 指标恢复正常时自动下发停止告警
    - 碰撞避免: 指数退避 + 侦听避让 + RX窗口快发 + 6次重试
    - GPS 按需开启: 上报窗口期预热, 其余时间空转省电
    - 上报间隔优化: Water_status 30s, DeviceStatus 60s, GPS 60s
    - 北京时间同步: sync_time 命令 +Unix时间戳 UTC+8 转换
    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
2026-06-22 docs: 更新问题汇总 — 新增第9章(一网关多终端+告警重构+碰撞避免)共10个问题
2026-06-25 fix: 修复终端运行一段时间后传感器停采+无法接收云端告警
    根因分析与修复:
    1. [CRITICAL] Debug_Printf 用互斥锁替代 taskENTER_CRITICAL
    - 原 taskENTER_CRITICAL 关闭所有中断后 UART 发送无超时，USART1 硬件
    故障时全局死锁(LoRa/GPS ISR+调度器全停)，启动代码在WDG_Init之前
    也有Debug_Printf调用，导致看门狗启动前就可能永久挂死
    - 修复: xSemaphoreTake(200ms超时) + TXE/TC等循环加100000次超时保护
    2. [HIGH] LoRa帧状态机无超时→噪声伪装帧头后永久吞噬数据
    - 修复: 新增500ms帧接收超时，超时自动复位到FRAME_IDLE
    3. [HIGH] LoRa发送期间ISR缓冲区溢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
    [iot_transport.c, lora.c, lora.h, main.c, usart_debug.c]
